TroyHurstCoding/PixelPressBox/case/accel_mount.png

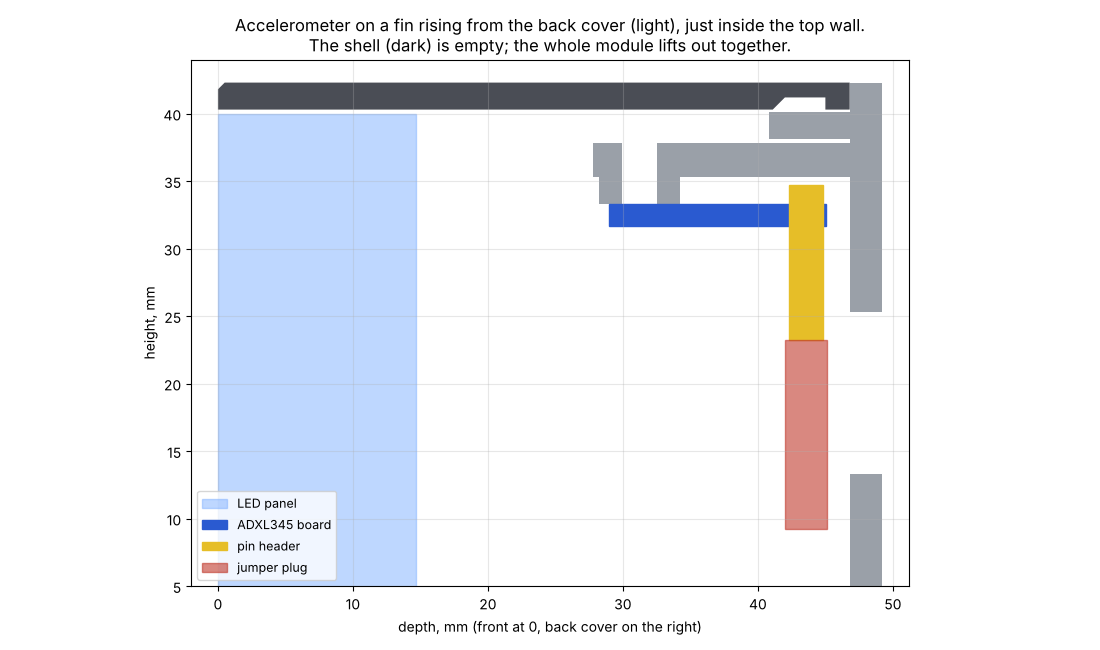
case/accel_mount.png
