TroyHurstCoding/PixelPressBox/case/board_3d.png

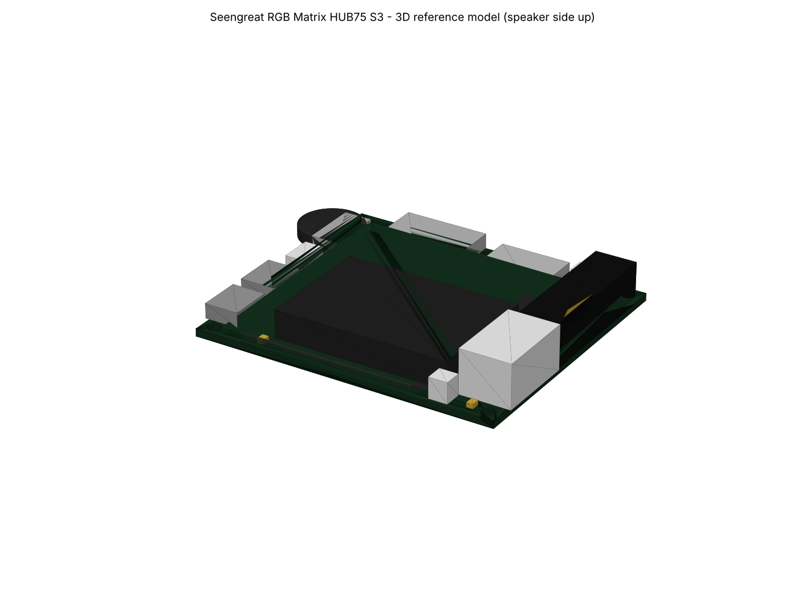
case/board_3d.png
