TroyHurstCoding/PixelPressBox/case/board_drawing.png

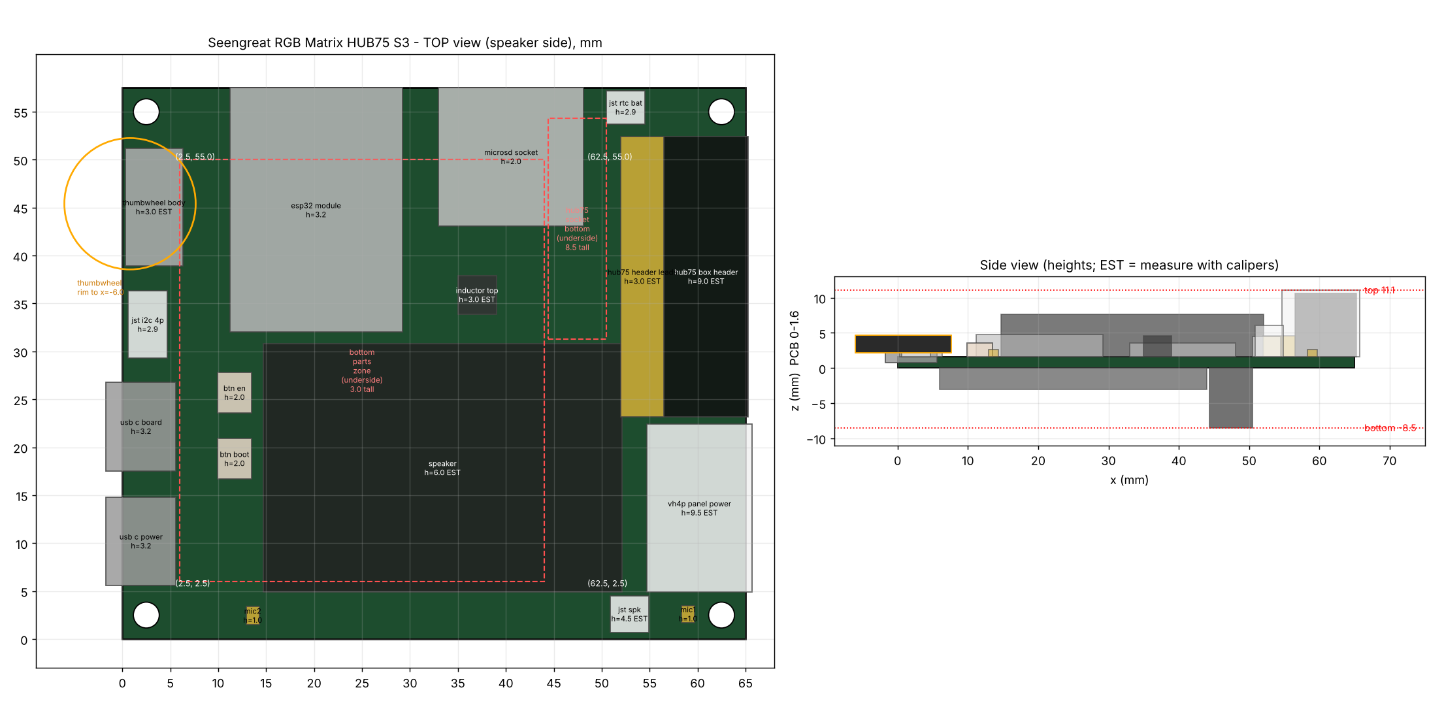
case/board_drawing.png
