TroyHurstCoding/PixelPressBox/case/case_section.png

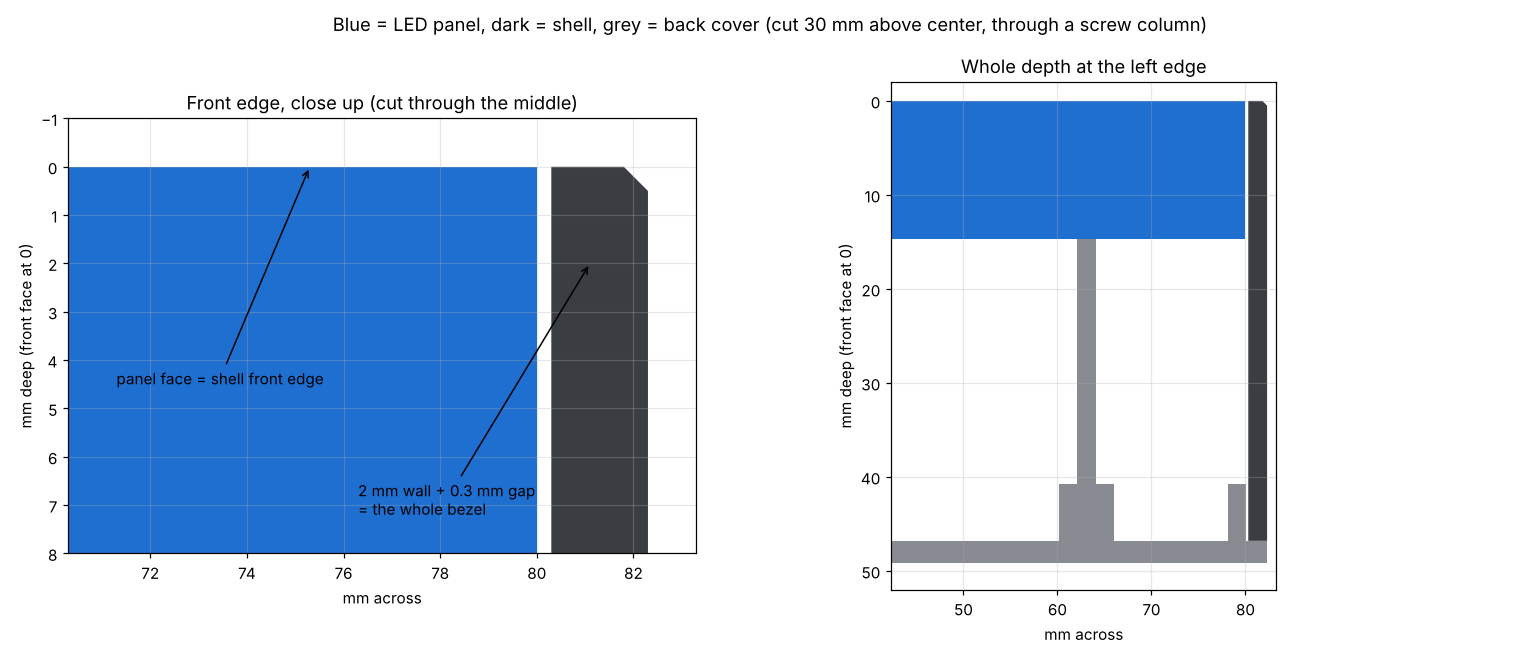
case/case_section.png
