TroyHurstCoding/PixelPressBox/case/snap_fit.png

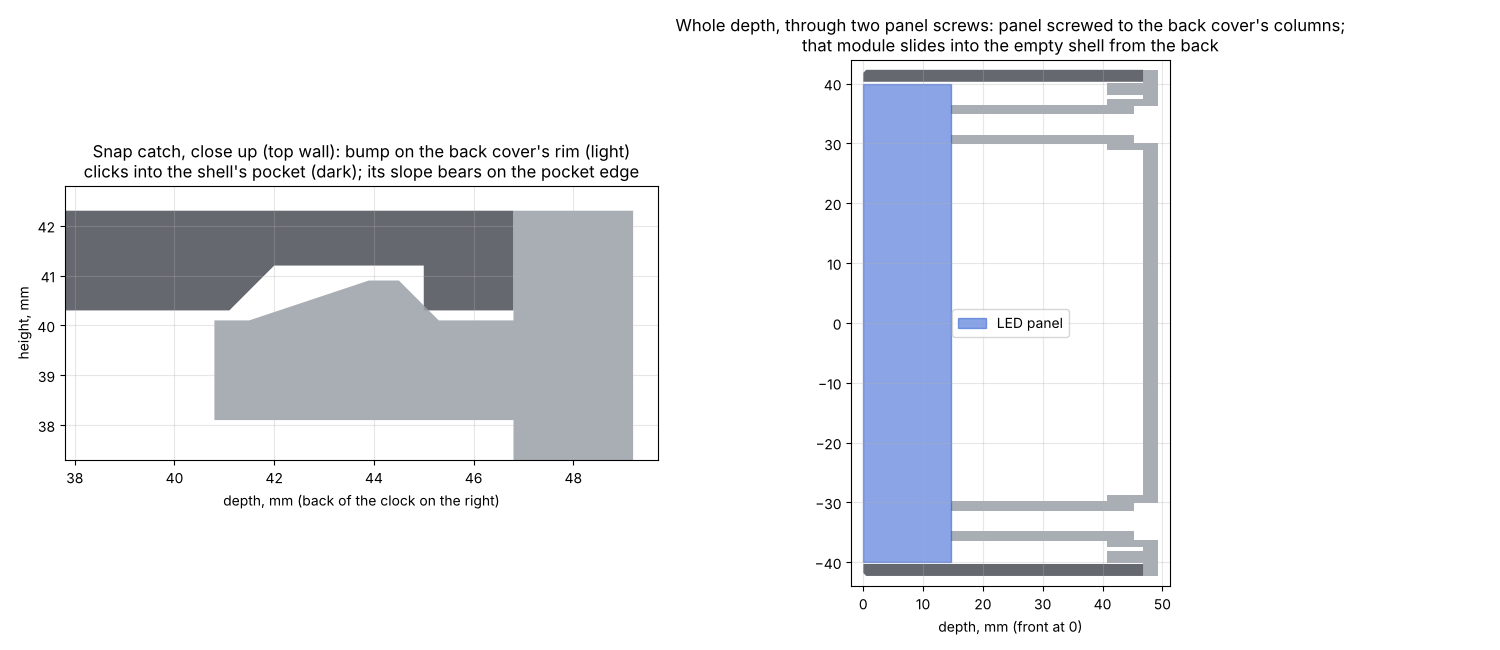
case/snap_fit.png
