TroyHurstCoding/PixelPressBox/case_preview.png

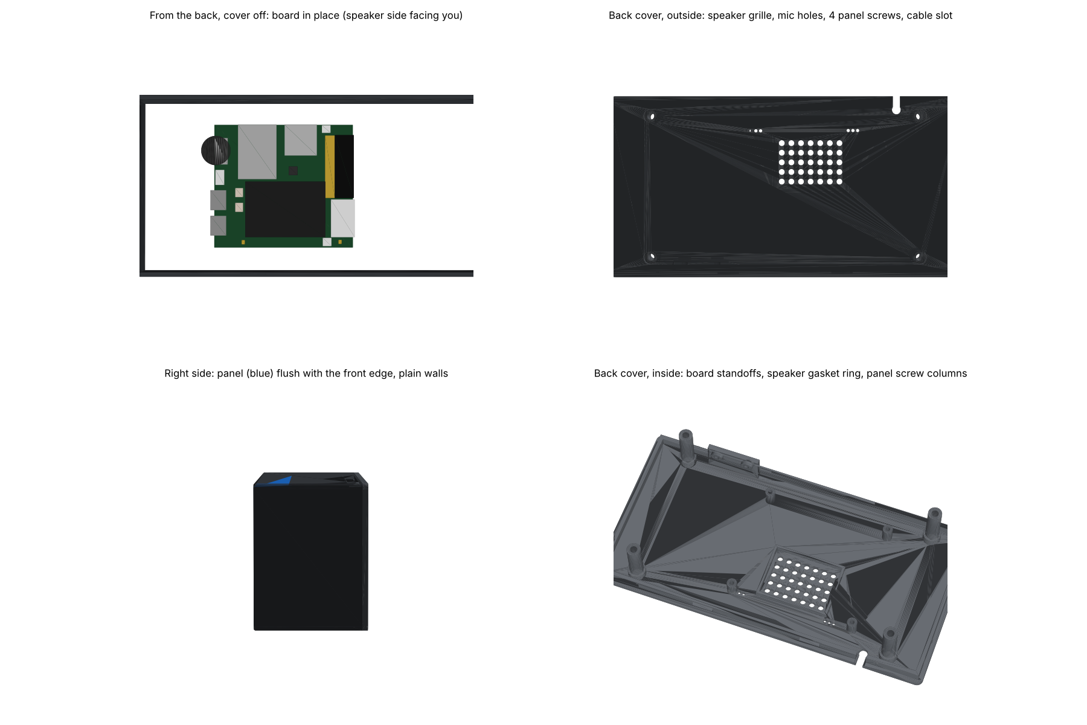
case_preview.png
