TroyHurstCoding/PixelPressBox/case_side_port.png

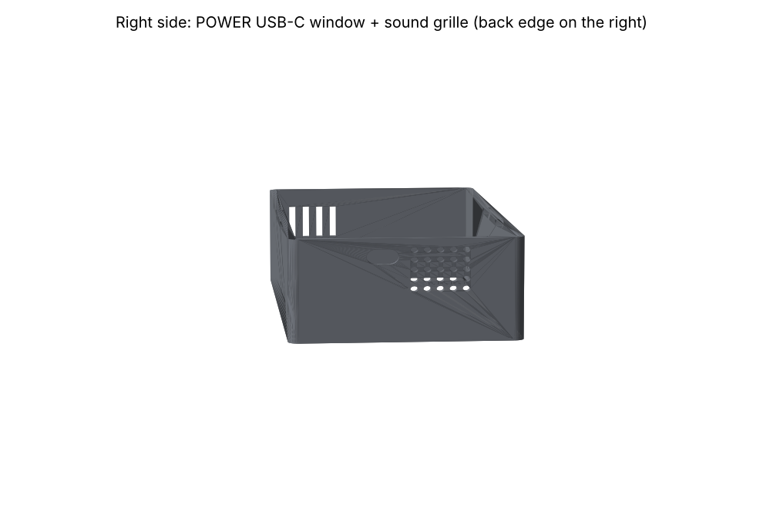
case_side_port.png
