TroyHurstCoding/PixelPressBox/screens_preview.png

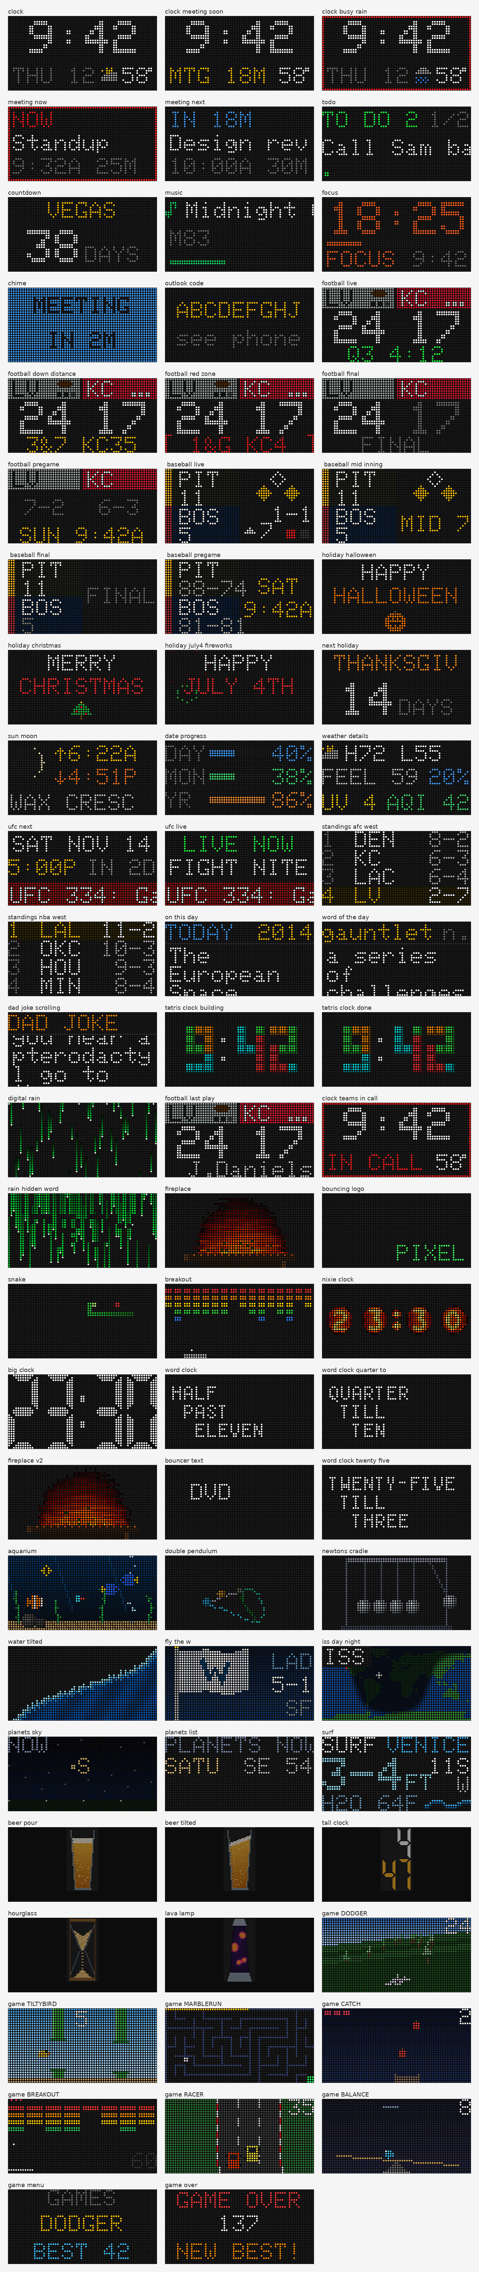
screens_preview.png
