TroyHurstCoding/PixelPressBox/case/GY-291_ADXL345_module.step

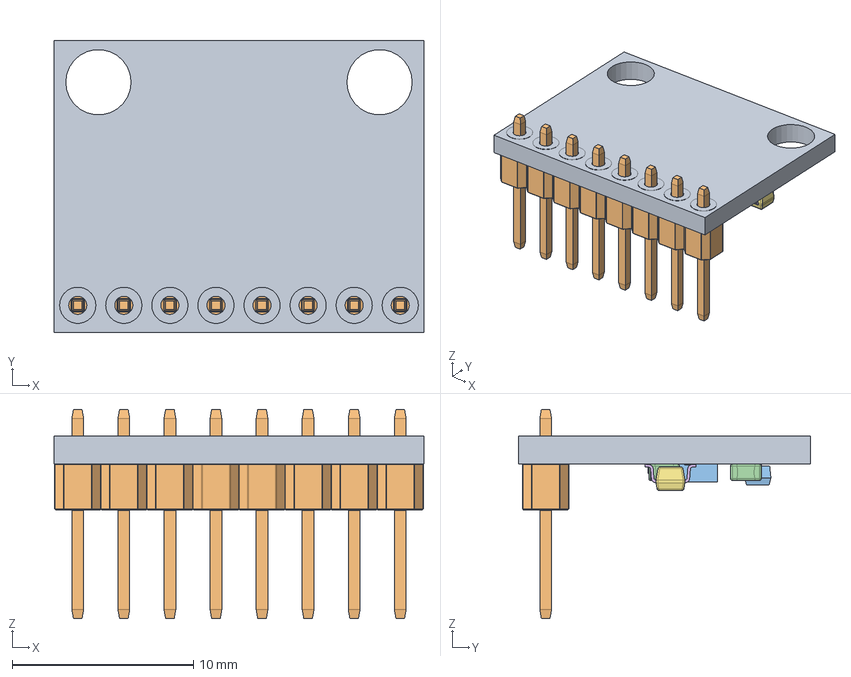
[picture p9: CAD file, 2026-11-13]
case/GY-291_ADXL345_module.step
20.4 x 16.1 x 11.5 mm
PCB
Pin Header
SMD Components
