TroyHurstCoding/PixelPressBox/case/stl/lid.stl

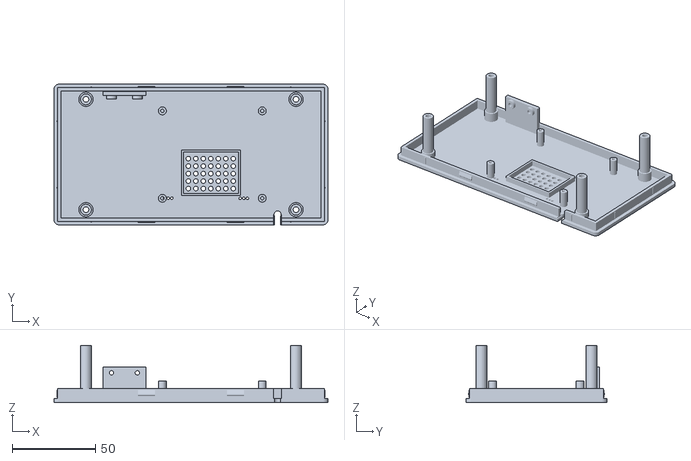
[picture p10: CAD file, 2026-11-13]
case/stl/lid.stl
164.6 x 84.6 x 34.5
