TroyHurstCoding/PixelPressBox/case/stl/fit_test.stl

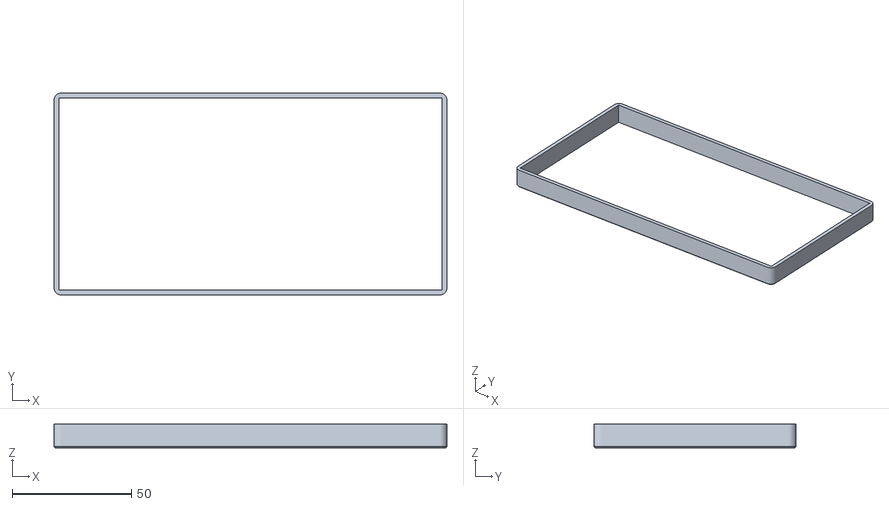
[picture p11: CAD file, 2026-11-13]
case/stl/fit_test.stl
164.6 x 84.6 x 10.0
