TroyHurstCoding/PixelPressBox/case/stl/shell.stl

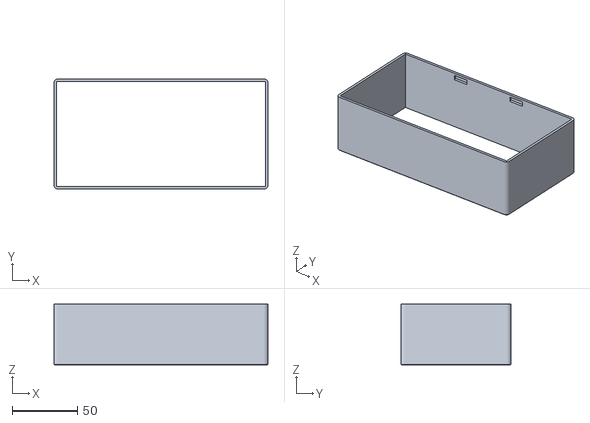
[picture p12: CAD file, 2026-11-13]
case/stl/shell.stl
164.6 x 84.6 x 46.8
