TroyHurstCoding/PixelPressBox/case/stl/stand.stl

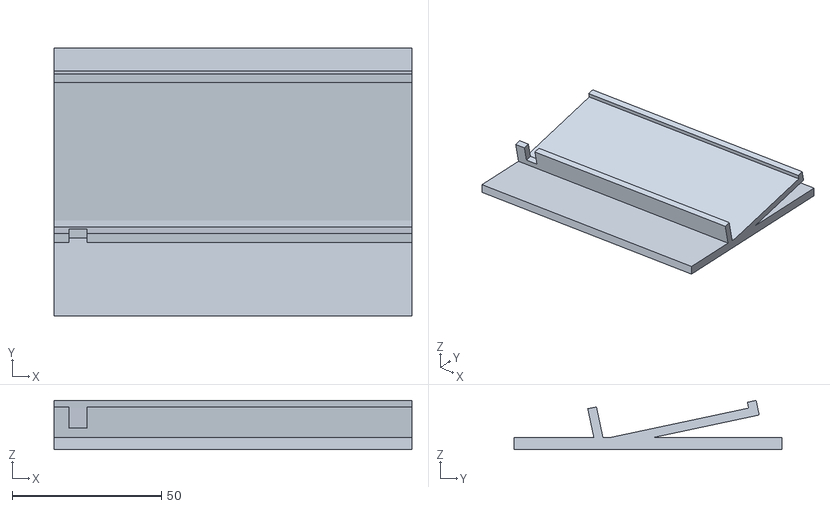
[picture p13: CAD file, 2026-11-13]
case/stl/stand.stl
120.0 x 89.8 x 16.5
