TroyHurstCoding/PixelPressBox/case/stl/seengreat_board.stl

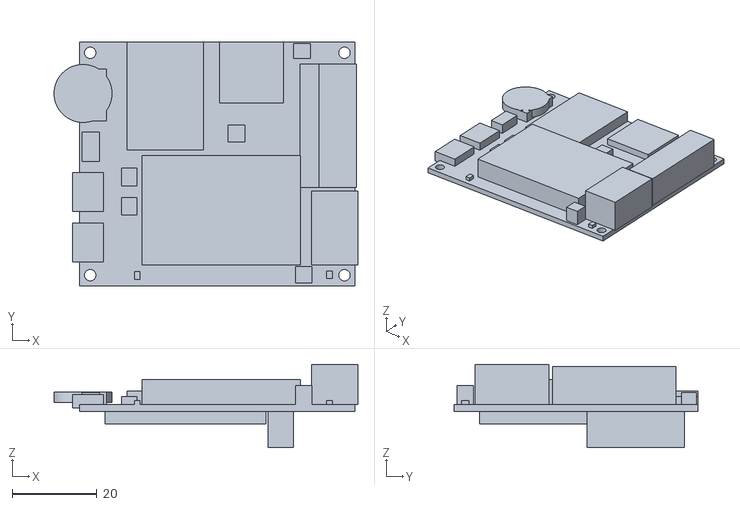
[picture p14: CAD file, 2026-11-13]
case/stl/seengreat_board.stl
71.7 x 57.5 x 19.6
