TroyHurstCoding/PixelPressBox/case/fit_test.png

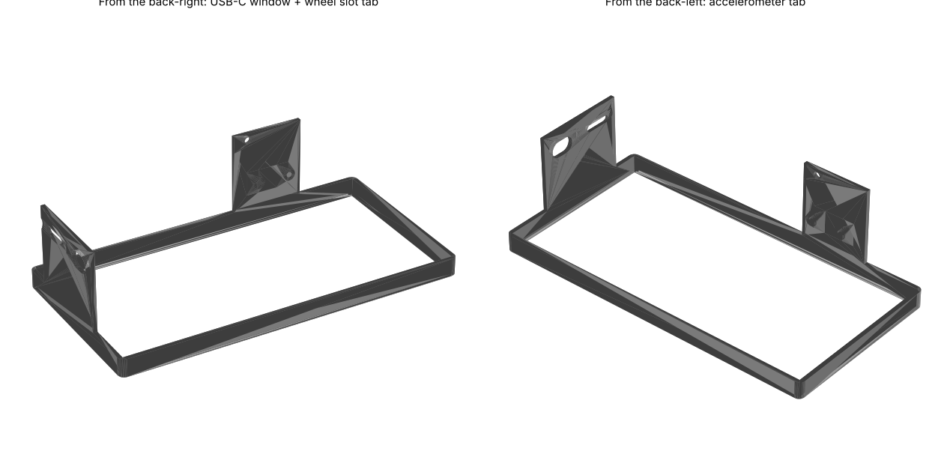
case/fit_test.png
