TroyHurstCoding/PixelPressBox/(commit log)

2026-11-13 PixelPressbox firmware, case and first auto-update release 2026.11.12-2033
    ESP32-S3 (Seengreat RGB Matrix HUB75 S3) desk clock + sports ticker for a 64x32 HUB75 panel:
    clock, weather, Outlook calendar and Teams busy light, to-dos, focus timer, holidays, countdowns,
    NFL/MLB/NBA scoreboards, standings, UFC, Spotify, Tetris clock and more. Nightly self-update from
    firmware/manifest.json in this repo.
    Claude-Session: https://claude.ai/code/session_0129KYgCLwfnntaEqvSFaR1V
    [diffuser.stl, lid.stl, louver.stl, partitions.csv, seengreat_board.stl, shell.stl, stand.stl]
2026-11-13 Release 2026.11.12-2050: background downloads, fun screens, image shuffle
    - Fix the "frozen" screen: all network downloads now run in a background task on core 0;
    the display loop never waits on WiFi. Daily feeds back off for 10 minutes when a source is down.
    - Digital rain can hide a word that shows up as negative space (cards.rain_word).
    - New screens: fireplace, bouncing logo, self-playing Snake and Breakout.
    - Image shuffle from /images on the SD card: animated GIF, PNG, JPG (bitbank2 decoders),
    plus tools/make_images.py to convert pictures to 64x32.
    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
    [autoupdate.cpp, autoupdate.h, images.cpp, images.h, main.cpp, model.h]
2026-11-13 Release 2026.11.12-2128: nixie, big and word clocks; new fireplace
    - Clock styles: nixie tubes, full-height segment digits, word clock ("HALF / PAST / ELEVEN").
    clock.style picks the main clock; the others can rotate in as cards.
    - Fireplace redone with a darker, natural fire palette and glowing logs.
    - Bouncing logo is now just colored text (cards.bounce_text).
    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
2026-11-13 Redesign nixie, big and word clocks and the fireplace after the Tronbyt apps
    Ports Nixel Clock (saltedlolly), Big Clock (Joey Hoer), Fuzzy Clock (Max Timkovich)
    and Tidbyt's Yule Log from tronbyt/apps (Apache-2.0); credits in NOTICE.
    Release 2026.11.12-2137.
    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
    [desk.cpp, images.cpp, images.h, main.cpp, render.cpp, sim.cpp]
2026-11-13 Check for update: run right away and show progress on the phone page
    The button only queued the check for the main loop, which reaches it between cards,
    and the page showed nothing meanwhile. Now the network task checks within a second
    and the page shows checking / downloading KB / up to date / errors.
    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
    [autoupdate.cpp, autoupdate.h, main.cpp, web.cpp]
2026-11-13 Warmer nixie tubes and deeper fireplace colors
    Nixie digits are recolored by brightness (red glass, orange glow, pale yellow core);
    the Yule Log gets a gamma curve and a little saturation so it isn't washed out on LEDs.
    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
2026-11-13 Digital rain word: normal rain on black, skipping the letters
    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
    [render.cpp]
2026-11-13 Case v2: panel flush with the front edge, 2 mm walls, no louver or diffuser
    Open-front shell (2.3 mm bezel), lid columns set the panel's depth, 0.5 mm front bevel,
    fit_test_ring.stl for a quick fit check. 164.6 x 84.6 x 46.8 mm.
    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
    [diffuser.stl, fit_test_ring.stl, lid.stl, louver.stl, shell.stl, stand.stl]
2026-11-13 Case: no wall slots; back cover gets a bottom intake row under the top vents
    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
    [fit_test_ring.stl, lid.stl, shell.stl]
2026-11-13 Add Ender-3 S1 Pro print settings for the case
    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
2026-11-13 Case: ADXL345 posts inside the shell's top wall
    Sized from the GY-291 STEP model: 3.6 mm holes 15.5 mm apart. 45 degree ramps keep the
    shell support-free when printed front-down; check() keeps the ramps clear of the panel.
    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
    [GY-291_ADXL345_module.step, fit_test_ring.stl, shell.stl]
2026-11-13 Case: bigger fit test with the USB-C, wheel and accelerometer features
    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
    [fit_test.stl, fit_test_ring.stl]
2026-11-13 Case: no wall openings; panel-mount USB-C on the back cover
    Board moves 35 mm in from the right wall so the wheel sits inside and the extension's
    plug has room. Back cover gets a panel-mount USB-C cut-out (18 mm M3 holes). Fit test
    is back to a plain 10 mm front ring.
    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
    [fit_test.stl, lid.stl, shell.stl]
2026-11-13 Case: hard-wired power through a snap-in slot in the back cover
    Replaces the panel-mount USB-C. The cable snaps into a round hole with a narrower neck at
    the back cover's bottom edge; the rim gets a matching gap. Stand: front lip lowered to 2 mm
    so it never covers the flush panel, cable slot in the back lip.
    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
    [lid.stl, stand.stl]
2026-11-13 Case: back cover screws in from the back, countersunk into corner bosses
    No screws in the side walls; all four sides are flat for landscape or portrait. Bosses have
    sloped undersides so the shell still prints front-down without supports.
    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
    [fit_test.stl, lid.stl, shell.stl]
2026-11-13 Case: panel stop tabs in the shell; panel comes out the front
    4 tabs reach in from the top/bottom walls behind the panel at each screw; the M3x35s pull the
    panel against them, lid columns only guide the screws. Shell now prints back-edge down so the
    tabs, bosses and accelerometer ramps all slope toward the bed.
    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
    [fit_test.stl, lid.stl, shell.stl]
2026-11-13 Case: full-depth panel pillars; back cover meets them flat
    Pillars run from the panel to the shell's back edge; M3x40 countersunk screws clamp back
    cover, pillar and panel as one stack. Lid columns removed.
    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
    [fit_test.stl, lid.stl, shell.stl]
2026-11-13 Case v3: snap-together module in an empty sleeve
    Panel + board + power cable live on the back cover; it snaps into the shell with 4 hidden
    catches on the long walls (45 deg catch faces with 0.1 mm preload) and 8 crush ribs. No
    screws on the outside. Shell prints front-down again; pillars and corner bosses removed.
    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
    [fit_test.stl, lid.stl, shell.stl]
2026-11-13 Case: accelerometer moves to a fin on the back cover; shell is empty
    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
    [fit_test.stl, lid.stl, shell.stl]
2026-11-13 Case: drop the back cover's vent slots
    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
    [lid.stl]
2026-11-14 Batch 3: accelerometer, portrait screens, 15 new cards
    ADXL345 driver (orientation, taps, flat = screen off, upside-down flip) with portrait mode:
    beer glass, tall clock, hourglass, lava lamp. New cards: aquarium, double pendulum, Newton's
    cradle, tilt-able water, trivia, facts/quotes, Billboard throwback, Fly the W, ISS day/night
    map, planets tonight, national day, surf report, Hacker News. Release 2026.11.13-1643.
    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
    [ESP32-HUB75-MatrixPanel-I2S-DMA.h, astro.cpp, astro.h, feeds2.cpp, feeds2.h, main.cpp]
2026-11-14 Games: Dodger, TiltyBird, MarbleRun, Catch, Breakout, Racer, Balance
    Shake or the phone page opens a tilt-to-pick menu; double tap quits. Best scores
    saved on the clock; without the accelerometer the games play themselves.
    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
